HydrogreenPollub/energy-flow-v2-pcb/schematic-main wtyczki.jpg

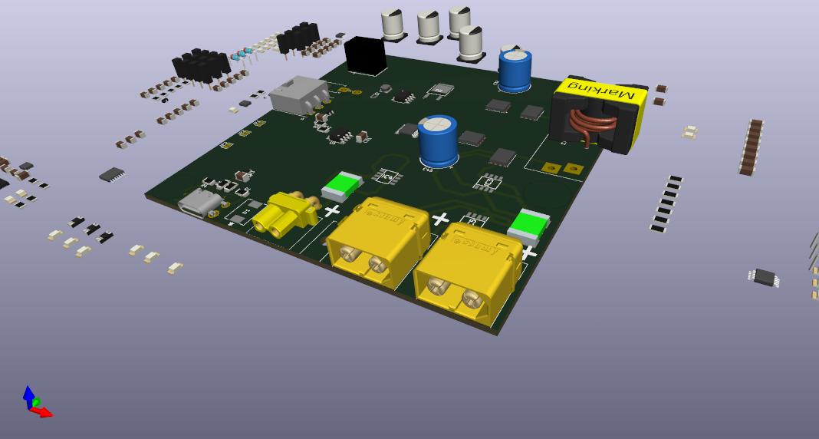
schematic-main wtyczki.jpg
