HydrogreenPollub/energy-flow-v2-pcb/README.md

## Energy flow PCB

CADLAB preview: [link](https://cadlab.io/project/27708)
