HydrogreenPollub/energy-flow-v2-pcb/kalkulacje przetwornicy Hydros.pdf

Typical Applications | Used when output is always lower than the input and small size is needed | The Transfer Function of a Buck Converter: (VOUT+VF)/(VIN-VRDSon) = D Requirements: Fill in shaded regions:
Advantages | High efficiency especially if the Schottky diode is replaced by a synchronous switch.
Low switch stress equal to the input voltage plus the forward voltage of the diode. | The output voltage of the converter: VOUT = | 46 | V
| The input voltage of the converter: VIN = | 55 | V
Low output ripple means a relatively small output filter.The nominal output current: | IOUT = | 2 | A
Disadvantages | Only one output. | Output power of the converter: POUT = 92 W
| Non-isolated. | The minimum output current: IOUTMIN = 0,2 A, assumed to be 10% of IOUT
Large EMI filter for high input ripple current due to input current always being discontinuous even though the inductor current can be either continuous or discontinuous. | The switching frequency of the converter: fSW = | 25 | kHz
Maximum allowable peak-to-peak ripple: | Vpp_ripple= | 0,46 V, assumed to be 1% of VOUT
Forward voltage drop across diode: VF = | 0,25 | V
Requires a high-side switch drive. | RDSon of switch at operating point: RDSon = | 0,01 | W
Voltage drop across RDSon: | VRDSon = | 0,02 V
Conduction losses of switch: | PCOND = | 0,034 W
Switching Period: | T = | 40 ms
On-time of the switch: | tON = 33,649 ms
Minimum inductor value: | L = 755,41 mH
Inductor stored energy: | E = 1828,1 mJ
Peak-to-peak ripple current: | IppRIPPLE = | 0,4 A
Peak switch current: | IPEAK = | 2,2 A
RMS current: | IRMS = | 1,837 A
DC blocking voltage: | VR = | 55 V
Average rectified output current: | IAVE = | 0,318 A
Minimum rated Drain to Source voltage: | VDS = | 60,25 V
Output capacitor RMS ripple current: | IRMScap = | 0,115 A
Minimum output capacitance: | COUT = | 4,35 mF
Total capacitance of output bank used: | COUTbank = | 82 | mF
Maximum ESR required: | ESRMAX = 1,1484 W
Actual ESR of output capacitor bank used: | ESR = | 0,015 | W
Input capacitor RMS ripple current: | IRMS = | 1,837 A
Acceptable input voltage ripple: | VrippleIN = | 2,750 V, assumed to be 5% of VIN
Minimum input capacitance: | CIN = | 4 mF
Total capacitance of input bank used: | CINbank = | 47 | mF
Maximum ESR required: | ESRMAX = 1,2455 W
Actual ESR of input capacitor bank used: | ESR = | 0,1 | W

## BUCK (Step Down)

The switch must be selected to meet the above current requirements. The major Drain to Source voltage stress occurs at switch turn-off when the Source could possibly ring up to 5V below ground.

The output capacitor is chosen such that it provides significant filtering of the switching ripple. The selected capacitor must be large enough so that its impedance is much smaller than the load at the switching frequency, allowing most of the ripple current to flow through the capacitor, not the load. The ripple current flowing through the output capacitor is equal to the inductor current waveform with the dc component removed. The output capacitor's ESR must also be taken into account because this parasitic resistance, which is out of phase with its capacitance, will cause additional voltage ripple. Be sure to select capacitors based upon their maximum ripple current and ESR ratings at the temperature and frequency of the application.

Chances are, a bank of capacitors will be required to handle the output ripple current. This capacitance will have an ESR associated with it:

0,841

The minimum inductor value is calculated assuming the minimum output current is equal to 10% of the nominal current. The inductor is sized such that the converter will remain in the continuous current mode through this range.

The drain current waveform is a ramp on a step. The value of the current at the center of the ramp is equal to the output DC current. The peak inductor current is equal to the output current added to half the peak to peak ripple.

A Schottky rectifier is chosen because of its low forward voltage, VF, and its excellent reverse recovery characteristics. Replacing this diode with a FET and using synchronous rectification will give even more efficiency benefits. This rectifier must meet the following criteria:

Duty Cycle: | D =
VPPtotal = | 0,025 V

Peak-to-peak voltage ripple due to output
ESR: | VPPESR = | 0,006 V

The same logic is applied when selecting the input capacitor. This capacitor, or bank of capacitors, will experience very high ripple current; the same current that is at the switch drain. An acceptable level of input voltage ripple which would still maintain regulation is assumed to be 5%.

Peak-to-peak voltage ripple due to input
capacitance: | VPPcap = | 0,234 V

Peak-to-peak voltage ripple due to output
capacitance: | VPPcap = | 0,024 V

Resultant total peak-to-peak output voltage
ripple:

0,220

0,321

V

V

Resultant total peak-to-peak input voltage
ripple:

Peak-to-peak voltage ripple due to input
ESR: | VPPESR =
| VPPtotal =
VIN | VOUT

+

- +
- Q1
D1

L1

## COUT BUCK

G

## ton T

t

VG

S D

VDS

t

## VIN+VF

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
IOUT

dI

dI

IOUT

IL1

IPEAK

IPEAK

dI

IPEAK

ISTEP

ISTEP

ICOUT | t dI 0
