HydrogreenPollub/energy-flow-v2-pcb/schematic-main.kicad_pcb

## KiCad design schematic-main.kicad_pcb (2024-03-30)

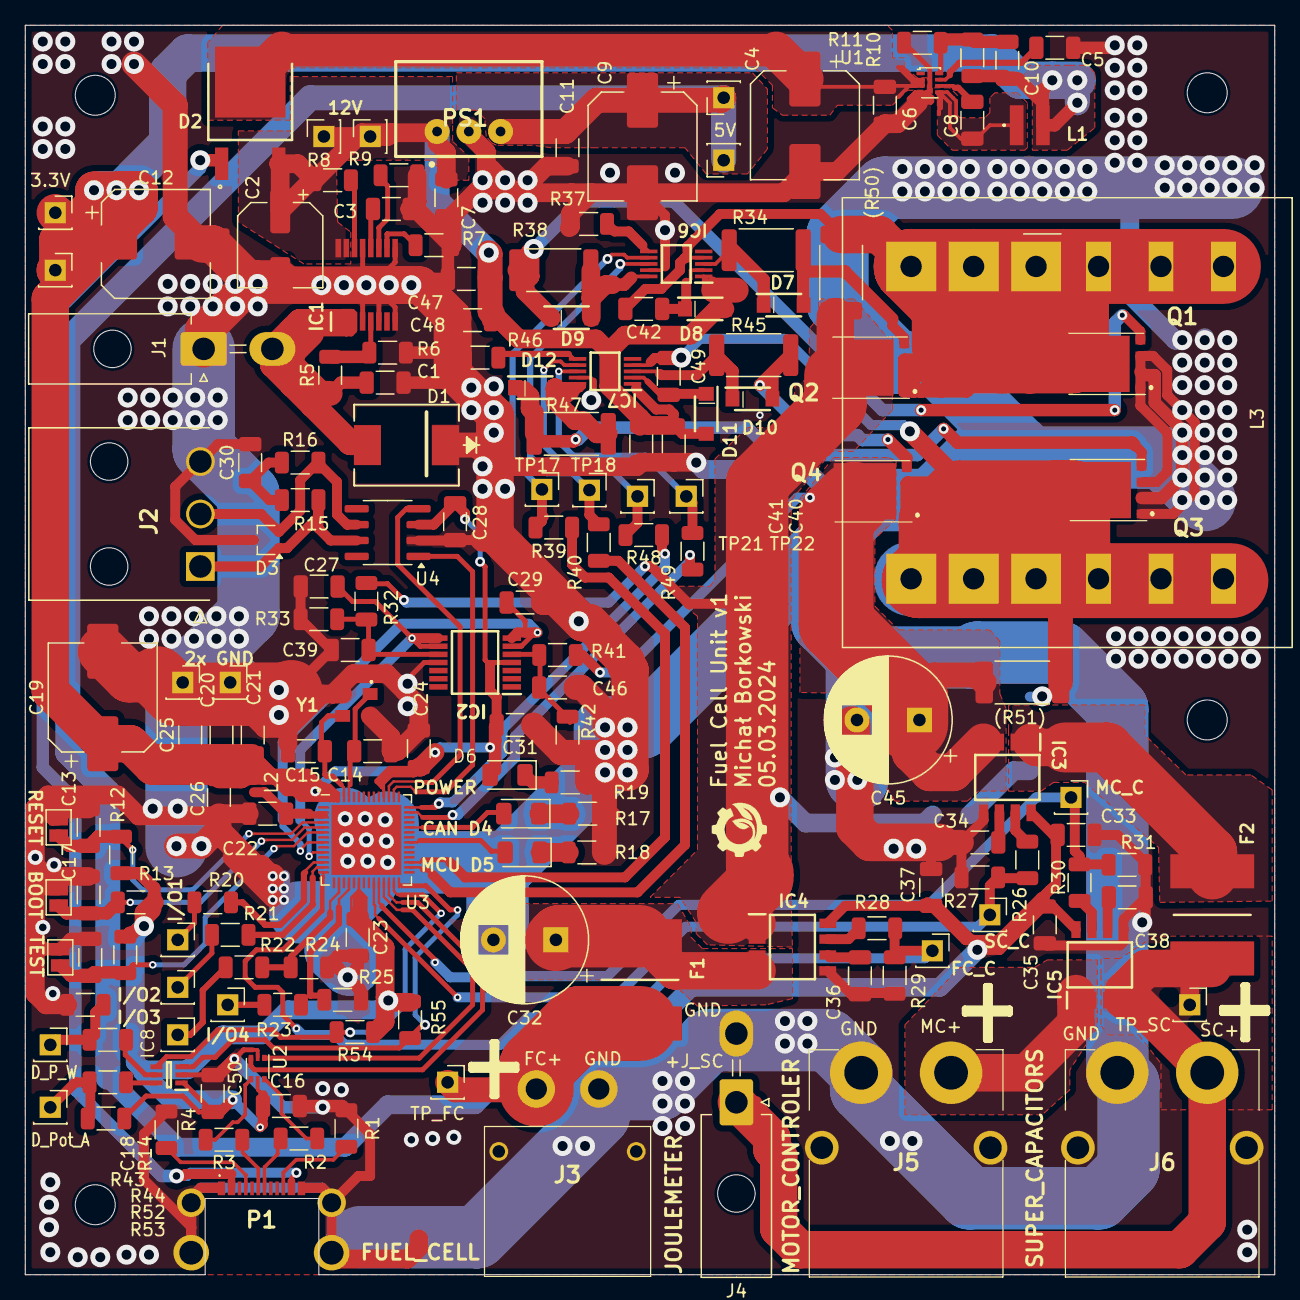
[picture p12: board schematic-main.kicad_pcb from above]

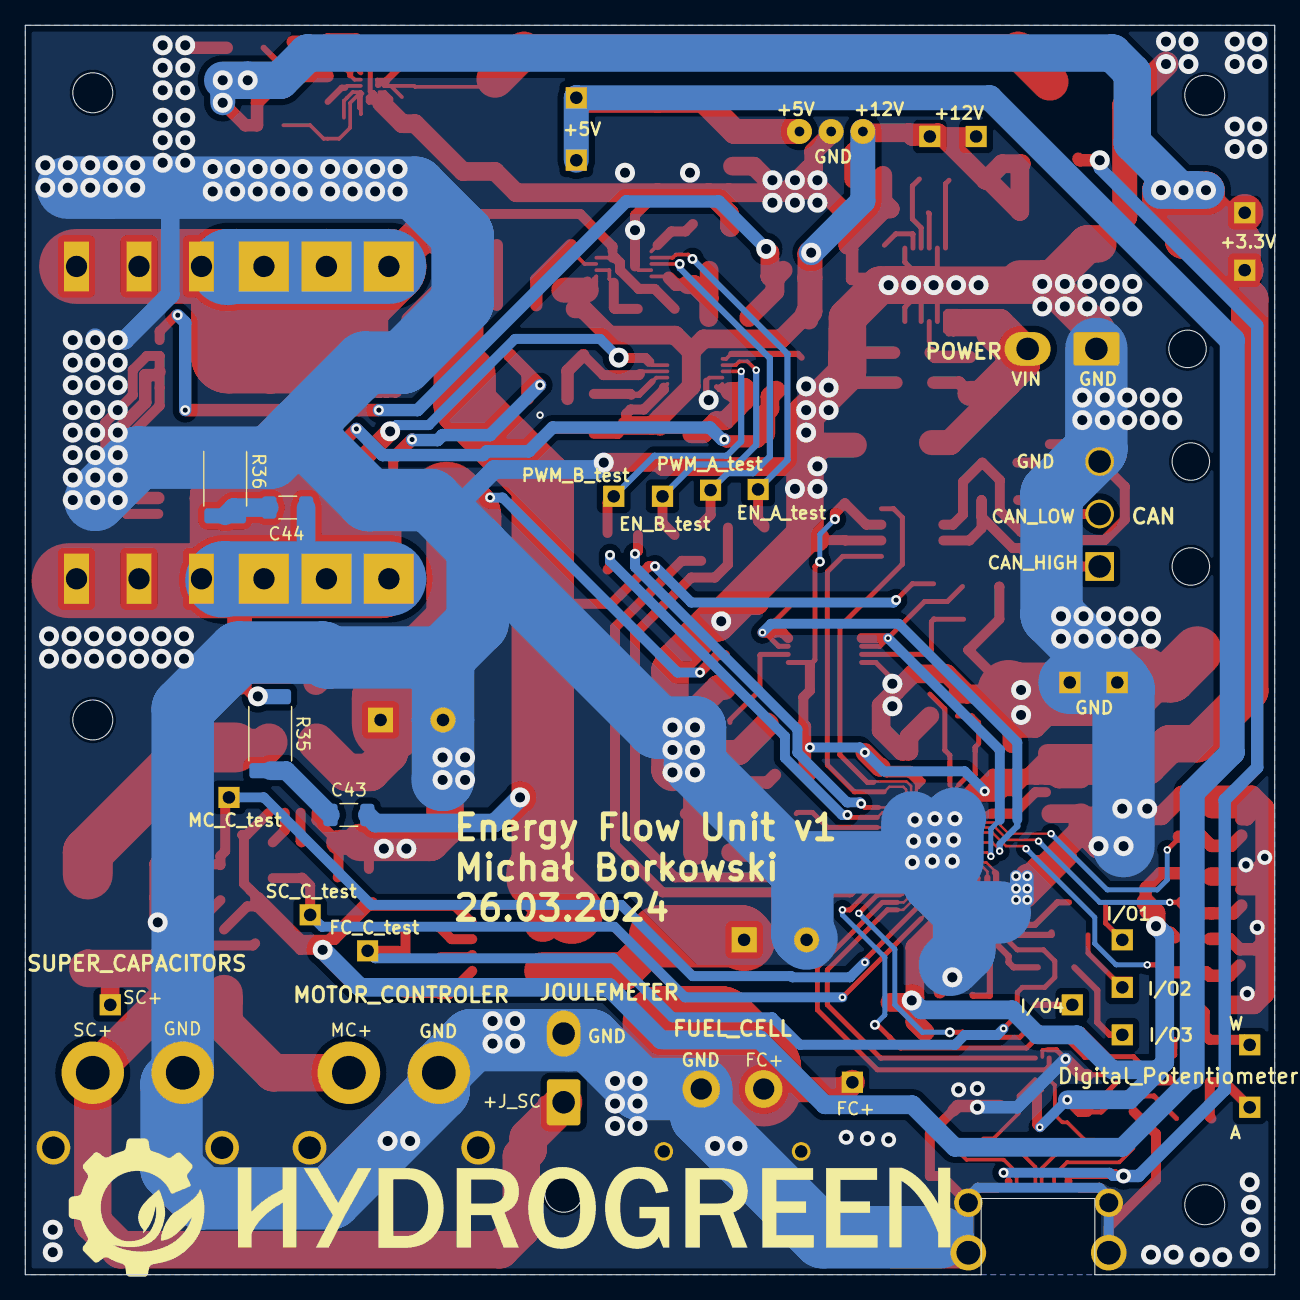
[picture p13: board schematic-main.kicad_pcb from below]

Board: 2 copper layers, 100.0 x 100.0 mm, 173 parts (4 on the bottom side), 96 nets.

Parts:
3.3V: +3.3V; PinSocket_1x01_P2.54mm_Vertical
5V: +5V; PinSocket_1x01_P2.54mm_Vertical
12V: +12V; PinSocket_1x01_P2.54mm_Vertical
 D6: LED; D_1206_3216Metric
(R50), (R51): 0R; R_2512_6332Metric_Pad1.40x3.35mm_HandSolder
BOOT: SolderJumper_2_Open; SolderJumper-2_P1.3mm_Open_Pad1.0x1.5mm
C1, C13, C17, C18, C20, C25: 1u; C_1206_3216Metric
C2: 47u; CP_Elec_6.3x7.7
C3: 2n7; C_1206_3216Metric
C4, C9, C19: 10u; CP_Elec_8x10.5
C5: 33n; C_1206_3216Metric
C6, C7, C8, C11, C16, C21, C22, C23, C24, C28, C31, C33, C35, C37, C50: 100n; C_1206_3216Metric
C10: 47p; C_1206_3216Metric
C12: 100u; CP_Elec_8x10.5
C14, C15: 12p; C_1206_3216Metric
C26, C41, C48: 10n; C_1206_3216Metric
C27, C29, C30: 4n7; C_1206_3216Metric
C32, C45: 100u 100V; CP_Radial_D10.0mm_P5.00mm
C34, C36, C38, C39, C46: 1n; C_1206_3216Metric
C40, C47: 470n; C_1206_3216Metric
C42, C49: 100n 100V; C_1206_3216Metric
C43, C44: 100p 100V; C_1206_3216Metric
CAN D4: LED; D_1206_3216Metric
D1: TPSMC30CA; TPSMCSeries_LTF
D2: MBRD20100CT-13; TO252_(DPAK)_1
D3: SP0502BAJT; SOT-323_SC-70
D7, D8, D9, D10, D11, D12: SKL120-AQ; SODFL3718X170N
D_P_W: D_Pot_W; PinSocket_1x01_P2.54mm_Vertical
D_Pot_A: D_Pot_A; PinSocket_1x01_P2.54mm_Vertical
F1, F2: 5A; FUSC8664X180N
FC_C: FC_C_test; PinSocket_1x01_P2.54mm_Vertical
I/O1: I/O 1; PinSocket_1x01_P2.54mm_Vertical
I/O2: I/O 2; PinSocket_1x01_P2.54mm_Vertical
I/O3: I/O 3; PinSocket_1x01_P2.54mm_Vertical
I/O4: I/O 4; PinSocket_1x01_P2.54mm_Vertical
IC1: LM76202QPWPRQ1; SOP65P640X120-17N
IC2: AD8544ARUZ-REEL; SOP65P640X120-14N
IC3, IC5: ACHS-7123-000E; SOIC127P606X204-8N
IC4: ACHS-7121-000E; SOIC127P606X204-8N
IC6, IC7: LM5106MMX_NOPB; SOP50P490X110-10N
IC8: MCP4018T-503E_LT; SOT65P210X110-6N
J1: Battery converter; Molex_Mini-Fit_Jr_5569-02A2_2x01_P4.20mm_Horizontal
J2: CAN; 39303035
J3: FUEL CELL; XT30PWF
J4: Joulemeter; Molex_Mini-Fit_Jr_5569-02A2_2x01_P4.20mm_Horizontal
J5: MOTOR CONTROLER; XT60PWM
J6: SUPER CAPACITORS; XT60PWM
L1: 4u7; SRN3015TA4R7M
L2: 2n; L_0402_1005Metric
L3: 700uH; L_Wurth_WE-HCFT-2012_LeadDiameter1.2mm
MCU D5: LED; D_1206_3216Metric
MC_C: MC_C_test; PinSocket_1x01_P2.54mm_Vertical
P1: USB_C_Plug_USB2.0; 2169900002
PS1: TSR_1-2450; TSR-1-24120
Q1, Q2, Q3, Q4: CSD19531Q5AT
R1, R4: 5k1; R_1206_3216Metric
R2, R3: 0; R_1206_3216Metric
R5: 180k; R_1206_3216Metric
R6: 12k; R_1206_3216Metric
R7, R8: 100k; R_1206_3216Metric
R9: 56k; R_1206_3216Metric
R10: 32k; R_1206_3216Metric
R11, R12, R13, R14, R24, R25, R26, R28, R30, R37, R43, R44, R46, R52, R53: 10k; R_1206_3216Metric
R15, R16: 60; R_1206_3216Metric
R17, R18, R19, R20, R21: 1k; R_1206_3216Metric
R22, R23: 100R; R_1206_3216Metric
R27, R29, R31: 20k; R_1206_3216Metric
R32: 68k; R_1206_3216Metric
R33: 3k9; R_1206_3216Metric
R34, R38, R45, R47: 10R 2W; R_2512_6332Metric
R35, R36: 100R 0,5W; R_2512_6332Metric
R39, R40, R48, R49: 200R; R_1206_3216Metric
R41: 62k; R_1206_3216Metric
R42: 4k7; R_1206_3216Metric
R54, R55: 4,7k; R_1206_3216Metric
RESET: SolderJumper_2_Open; SolderJumper-2_P1.3mm_Open_Pad1.0x1.5mm
SC_C: SC_C_test; PinSocket_1x01_P2.54mm_Vertical
TEST: SolderJumper_2_Open; SolderJumper-2_P1.3mm_Open_Pad1.0x1.5mm
TP1, TP2: GND; PinSocket_1x01_P2.54mm_Vertical
TP3: +12V; PinSocket_1x01_P2.54mm_Vertical
TP5: +5V; PinSocket_1x01_P2.54mm_Vertical
TP8: +3.3V; PinSocket_1x01_P2.54mm_Vertical
TP17: EN A test; PinSocket_1x01_P2.54mm_Vertical
TP18: PWM A test; PinSocket_1x01_P2.54mm_Vertical
TP21: EN B test; PinSocket_1x01_P2.54mm_Vertical
TP22: PWM B test; PinSocket_1x01_P2.54mm_Vertical
TP_FC: FC test; PinSocket_1x01_P2.54mm_Vertical
TP_SC: SC test; PinSocket_1x01_P2.54mm_Vertical
U1: TPS62933; SOT-583-8
U2: USBLC6-2P6; SOT-666
U3: ESP32-S3FN8; QFN-56-1EP_7x7mm_P0.4mm_EP5.6x5.6mm
U4: SN65HVD232; SOIC-8_3.9x4.9mm_P1.27mm
Y1: Crystal_GND24; KC3225K400000C1GE00

Connections:
+3.3V: 3.3V.1, D6.2 (A), C10.1, C12.1, C16.1, C19.1, C20.1, C21.1, C23.1, C24.1, C25.1, C26.1, C28.1, C31.1, C50.1, IC2.4 (V+), IC8.1 (VDD), L1.2, L2.1, R10.1, R12.2, R13.2, R14.2, R53.1, R54.1, R55.1, TP8.1, U2.5 (VBUS), U3.20 (VDD3P3_RTC), U3.46 (VDD3P3_CPU), U3.55 (VDDA), U3.56 (VDDA), U4.3 (VCC)
+5V: 5V.1, C9.1, C11.1, C33.1, C35.1, C37.1, IC3.8 (VDD), IC4.8 (VDD), IC5.8 (VDD), PS1.3 (VOUT+), TP5.1
+12V: 12V.1, C2.1, C7.1, C40.1, C41.1, C47.1, C48.1, D2.2, D8.2 (A), D11.2 (A), IC1.15 (OUT_1), IC1.16 (OUT_2), IC6.1 (VDD), IC7.1 (VDD), PS1.1 (VIN+), R8.1, TP3.1
/Converter/Bootstrap_A: (R50).2, C42.2, IC6.4 (HS), L3.1, Q1.5 (D_1), Q1.6 (D_2), Q1.7 (D_3), Q1.8 (D_4), Q1.9 (D_5), Q2.1 (S_1), Q2.2 (S_2), Q2.3 (S_3)
/Converter/Bootstrap_B: (R51).1, C44.1, C49.2, IC7.4 (HS), L3.2, Q3.5 (D_1), Q3.6 (D_2), Q3.7 (D_3), Q3.8 (D_4), Q3.9 (D_5), Q4.1 (S_1), Q4.2 (S_2), Q4.3 (S_3), R35.1
/Converter/Converter_ON_A_MCU: R39.1, U3.31 (SPIWP/GPIO28)
/Converter/Converter_ON_B_MCU: R48.1, U3.42 (GPIO37)
/Converter/Converter_PWM_A_MCU: R40.2, U3.30 (SPIHD/GPIO27)
/Converter/Converter_PWM_B_MCU: R49.2, U3.41 (GPIO36)
/Converter/FC+: F1.1, J3.2, TP_FC.1
/Converter/FC_V: C39.1, IC2.10 (+IN_C), R32.1, R33.2
/Converter/FC_c1: C32.1, F1.2, IC4.3 (IP-_1), IC4.4 (IP-_2)
/Converter/FC_c2: (R50).1, C43.1, IC4.1 (IP+_1), IC4.2 (IP+_2), Q2.5 (D_1), Q2.6 (D_2), Q2.7 (D_3), Q2.8 (D_4), Q2.9 (D_5), R32.2
/Converter/FC_c_MCU: FC_C.1, R28.1, R29.2, U3.14 (GPIO9/ADC1_CH8)
/Converter/High_mosfet_A: D7.2 (A), Q2.4 (G), R34.2
/Converter/High_mosfet_B: D10.2 (A), Q4.4 (G), R45.2
/Converter/Low_mosfet_A: D9.1 (K), Q1.4 (G), R38.1
/Converter/Low_mosfet_B: D12.1 (K), Q3.4 (G), R47.1
/Converter/MC_c1: F2.1, IC5.3 (IP-_1), IC5.4 (IP-_2), J4.1, J6.1, TP_SC.1
/Converter/MC_c2: IC5.1 (IP+_1), IC5.2 (IP+_2), J5.1
/Converter/MC_c_MCU: MC_C.1, R30.1, R31.2, U3.24 (GPIO18/ADC2_CH7)
/Converter/SC_V: C46.1, IC2.5 (+IN_B), R41.1, R42.2
/Converter/SC_c1: (R51).2, C45.1, IC3.3 (IP-_1), IC3.4 (IP-_2), Q4.5 (D_1), Q4.6 (D_2), Q4.7 (D_3), Q4.8 (D_4), Q4.9 (D_5), R41.2
/Converter/SC_c2: F2.2, IC3.1 (IP+_1), IC3.2 (IP+_2)
/Converter/SC_c_MCU: R26.1, R27.2, SC_C.1, U3.23 (GPIO17/ADC2_CH6)
/IO/CANH: D3.1 (K), J2.1, R15.2, U4.7 (CANH)
/IO/CANL: D3.2 (K), J2.2, R16.2, U4.6 (CANL)
/IO/CAN_RX: U3.44 (MTCK/JTAG/GPIO39), U4.1 (D)
/IO/CAN_TX: U3.45 (MTDO/JTAG/GPIO40), U4.4 (R)
/IO/FC_Voltage_MCU: C27.1, IC2.8 (OUT_C), IC2.9 (-IN_C), U3.10 (GPIO5/ADC1_CH4)
/IO/I/O_1_MCU: R20.2, U3.12 (GPIO7/ADC1_CH6)
/IO/I/O_2_MCU: R21.2, U3.13 (GPIO8/ADC1_CH7)
/IO/I/O_3_MCU: R22.2, R24.1, U3.16 (GPIO11/ADC2_CH0)
/IO/I/O_4_MCU: R23.2, R25.1, U3.18 (GPIO13/ADC2_CH2)
/IO/LED_CAN_STATUS: CAN D4.2 (A), U3.38 (GPIO33)
/IO/LED_MCU_STATUS: MCU D5.2 (A), U3.35 (SPID/GPIO32)
/IO/SCL_D_Pot_i2c_MCU: IC8.3 (SCL), R55.2, U3.28 (SPI_CS1/GPIO26)
/IO/SC_Voltage_MCU: C29.1, IC2.6 (-IN_B), IC2.7 (OUT_B), U3.8 (GPIO3/ADC1_CH2)
/IO/SDA_D_Pot_i2c_MCU: IC8.4 (SDA), R54.2, U3.27 (GPIO21)
/MCU/BOOT: BOOT.1 (A), C17.1, R13.1, U3.5 (GPIO0/BOOT)
/MCU/MCU_TEST: C18.1, R14.1, TEST.1 (A), U3.6 (GPIO1/ADC1_CH0)
/MCU/RESET: C13.1, R12.1, RESET.1 (A), U3.4 (CHIP_PU/RESET)
/MCU/USB_D+: R3.2, U2.3 (I/O2), U2.4 (I/O2), U3.26 (GPIO20/USB_D+/ADC2_CH9)
/MCU/USB_D-: R2.2, U2.1 (I/O1), U2.6 (I/O1), U3.25 (GPIO19/USB_D-/ADC2_CH8)
/MCU/XTAL_N: C14.1, U3.53 (XTAL_N), Y1.1
/MCU/XTAL_P: C15.1, U3.54 (XTAL_P), Y1.3
/Power /Vin: C1.1, D1.2 (A), IC1.1 (IN_1), IC1.2 (IN_2), IC1.3 (UVLO), J1.2, R5.1
/VBUS: D2.1, P1.A4 (VBUS), P1.A9 (VBUS), P1.B4 (VBUS), P1.B9 (VBUS)
GND: BOOT.2 (B), C1.2, C2.2, C3.2, C4.2, C5.2, C6.2, C7.2, C9.2, C11.2, C12.2, C13.2, C14.2, C15.2, C16.2, C17.2, C18.2, C19.2, C20.2, C21.2, C22.2, C23.2, C24.2, C25.2, C26.2, C27.2, C28.2, C29.2, C30.2, C31.2, C32.2, C33.2, C34.2, C35.2, C36.2, C37.2, C38.2, C39.2, C40.2, C41.2, C45.2, C46.2, C47.2, C48.2, C50.2, D1.1 (K), D3.3 (A), IC1.4 (NC_1), IC1.6 (MODE), IC1.8 (RTN), IC1.9 (GND), IC1.13 (NC_2), IC1.17 (EP), IC2.11 (GND), IC3.5 (GND), IC4.5 (GND), IC5.5 (GND), IC6.9 (VSS), IC7.9 (VSS), IC8.2 (VSS), J1.1, J2.3, J3.1, J4.2, J5.2, J6.2, P1.A1 (GND), P1.A12 (GND), P1.B1 (GND), P1.B12 (GND), PS1.2 (GND), Q1.1 (S_1), Q1.2 (S_2), Q1.3 (S_3), Q3.1 (S_1), Q3.2 (S_2), Q3.3 (S_3), R1.2, R4.2, R6.2, R7.2, R9.2, R11.2, R17.2, R18.2, R19.2, R24.2, R25.2, R27.1, R29.1, R31.1, R33.1, R36.1, R37.1, R42.1, R43.2, R46.1, RESET.2 (B), TEST.2 (B), TP1.1, TP2.1, U1.4 (GND), U2.2 (GND), U3.57 (GND), U4.2 (GND), Y1.2, Y1.4
unnamed: C30.1, R15.1, R16.1
unnamed: C43.2, R35.2
unnamed: C44.2, R36.2
unnamed: CAN D4.1 (K), R17.1
unnamed: MCU D5.1 (K), R18.1
unnamed: D6.1 (K), R19.1
unnamed: D7.1 (K), IC6.3 (HO), R34.1
unnamed: C42.1, D8.1 (K), IC6.2 (HB)
unnamed: D9.2 (A), IC6.10 (LO), R38.2
unnamed: D10.1 (K), IC7.3 (HO), R45.1
unnamed: C49.1, D11.1 (K), IC7.2 (HB)
unnamed: D12.2 (A), IC7.10 (LO), R47.2
unnamed: C3.1, IC1.12 (DVDT)
unnamed: IC1.11 (ILIM), R9.1
unnamed: IC1.10 (IMON), R7.1
unnamed: IC1.5 (OVP), R5.2, R6.1
unnamed: IC1.14 (~FLT), R8.2
unnamed: C34.1, IC3.6 (FILTER)
unnamed: IC3.7 (VOUT), R26.2
unnamed: C36.1, IC4.6 (FILTER)
unnamed: IC4.7 (VOUT), R28.2
unnamed: C38.1, IC5.6 (FILTER)
unnamed: IC5.7 (VOUT), R30.2
unnamed: IC6.7 (EN), R39.2, TP17.1
unnamed: IC6.8 (IN), R40.1, TP18.1
unnamed: IC6.6 (RDT), R37.2
unnamed: IC7.7 (EN), R48.2, TP21.1
unnamed: IC7.8 (IN), R49.1, TP22.1
unnamed: IC7.6 (RDT), R46.2
unnamed: IC8.6 (A), R52.2
unnamed: IC8.5 (W), R44.1
unnamed: P1.A5 (CC), R4.1
unnamed: P1.A6 (D+), R3.1
unnamed: P1.A7 (D-), R2.1
unnamed: P1.B5 (VCONN), R1.1
unnamed: I/O1.1, R20.1
unnamed: I/O2.1, R21.1
unnamed: I/O3.1, R22.1
unnamed: I/O4.1, R23.1
unnamed: D_P_W.1, R43.1, R44.2
unnamed: D_Pot_A.1, R52.1, R53.2
unnamed: C8.1, U1.6 (BST)
unnamed: C10.2, R10.2, R11.1, U1.8 (FB)
unnamed: C5.1, U1.7 (SS)
unnamed: C8.2, L1.1, U1.5 (SW)
unnamed: C4.1, C6.1, D2.3, U1.3 (VIN)
VDD3P3: C22.1, L2.2, U3.2 (VDD3P3), U3.3 (VDD3P3)
