HydrogreenPollub/energy-flow-v2-pcb/(commit log)

2024-01-27 First converter version
    [schematc-converter.kicad_sch, schematc-io.kicad_sch, schematic-converter.kicad_sch, schematic-main.kicad_sch, schematic-mcu.kicad_sch, schematic-power.kicad_sch, wzor.kicad_pcb]
2024-02-02 Repair files
    [schematc-converter.kicad_sch, schematc-io.kicad_sch, schematic-main.kicad_sch, schematic-mcu.kicad_sch, schematic-power.kicad_sch]
2024-02-07 Add test points
    [schematc-converter.kicad_sch, schematc-io.kicad_sch]
2024-02-07 Edit mosfets outputs
    [schematc-converter.kicad_sch, schematc-io.kicad_sch, schematic-main.kicad_sch, schematic-mcu.kicad_sch, schematic-power.kicad_sch]
2024-02-26 First pcb
    [schematc-converter.kicad_sch, schematc-io.kicad_sch, schematic-main.kicad_pcb, schematic-main.kicad_sch, schematic-mcu.kicad_sch, schematic-power.kicad_sch]
2024-03-12 Buck - boost converter
    [schematc-converter.kicad_sch, schematc-io.kicad_sch, schematic-main.kicad_pcb, schematic-main.kicad_sch, schematic-mcu.kicad_sch, schematic-power.kicad_sch]
2024-03-21 Add coil and microcontroler
    [schematic-main.kicad_pcb, schematic-main.kicad_sch]
2024-03-23 Add pot
    [schematc-io.kicad_sch, schematic-main.kicad_pcb, schematic-main.kicad_sch, schematic-mcu.kicad_sch]
2024-03-24 PCB design 50%
    [schematc-converter.kicad_sch, schematic-main.kicad_pcb, schematic-mcu.kicad_sch]
2024-03-24 PCB design 80%
    [schematc-converter.kicad_sch, schematc-io.kicad_sch, schematic-main.kicad_pcb, schematic-mcu.kicad_sch, schematic-power.kicad_sch]
2024-03-26 PCB design complate
    [schematc-converter.kicad_sch, schematic-main.kicad_pcb]
2024-03-30 DRC Tested
    [pcb.kicad_pcb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]
2024-04-05 Rename and send to production
    [pcb_schematic_main_EFU.kicad_pcb, wzor.kicad_pcb]
